Matlock42/AC_Clock/README.md

# AC Clock [WIP]  
I wanted to make a simplistic clock that would use 60Hz mains for both power and timing signal. This used to be quite common.
