Matlock42/AC_Clock/Docs/Readme.md

# Reference Designs

- [An Old-School Digital Clock - Nuts & Volts](https://www.nutsvolts.com/magazine/article/April2017_CMOS-ICs-Digital-Clock)

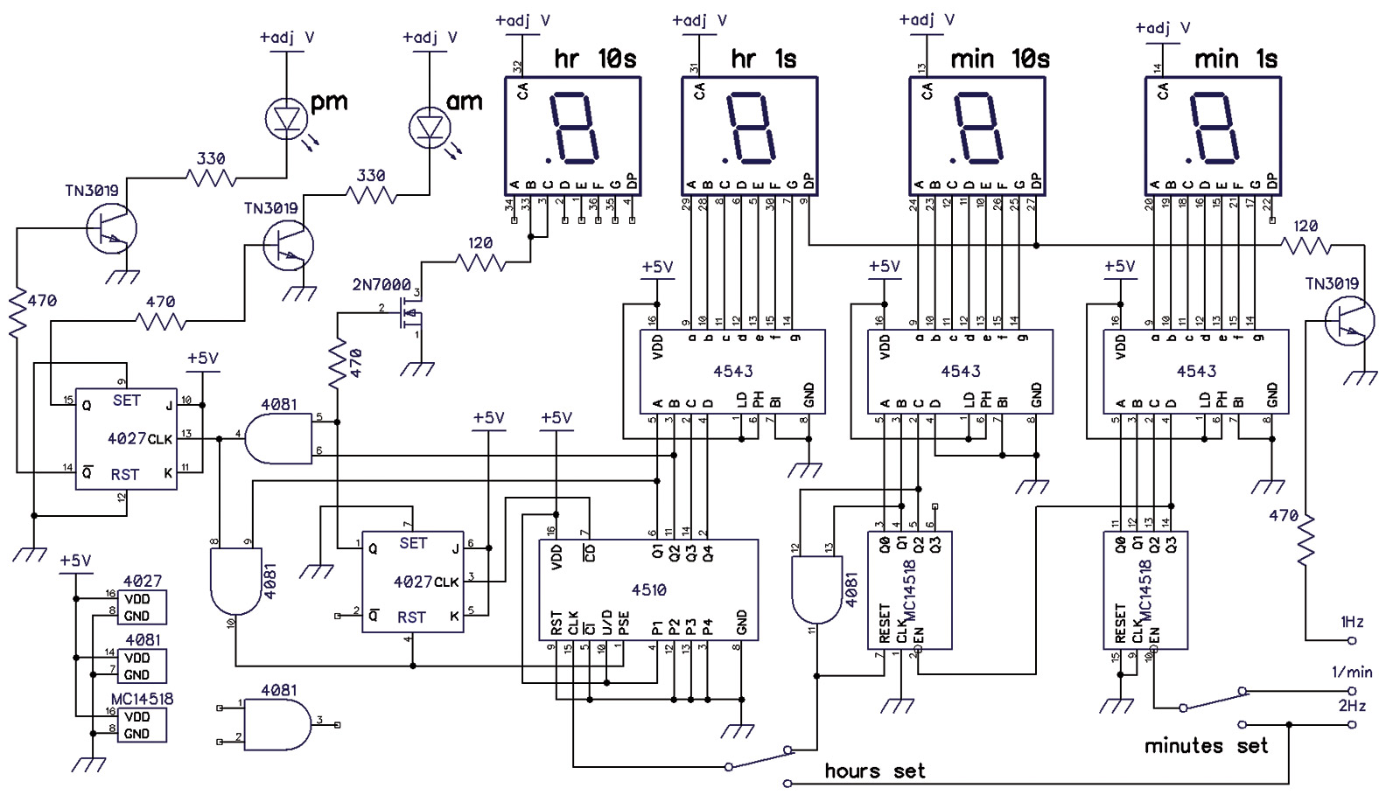
[picture p1: Docs/NV_0417_Julstrom_Figure03.jpg]
Counting Circuit


- [
Learning Sequential Logic Design for a Digital Clock by hp07](https://www.instructables.com/Digital-Clock-Sequential-Logic-Design/)
