Matlock42/AC_Clock/Calc/CurrentCalcs.xlsx

Device | MPN | Qty | I_max (mA) | Total
Counter | SN74HC393 | 4 | 15 | 60
BCD-to-7-Segment | CD74HC4511M96 | 4 | 0.1 | 0.4
Octocoupler | LTV-817S | 1 | 5 | 5
LED 7-segment | HDSP-815E | 4 | 70 | 280
12-stage Counter | CD4040B | 1
 |  |  |  | 345.4
