Matlock42/AC_Clock/Hardware/AC_Clock.kicad_pcb

## KiCad design Hardware/AC_Clock.kicad_pcb (2024-07-30)

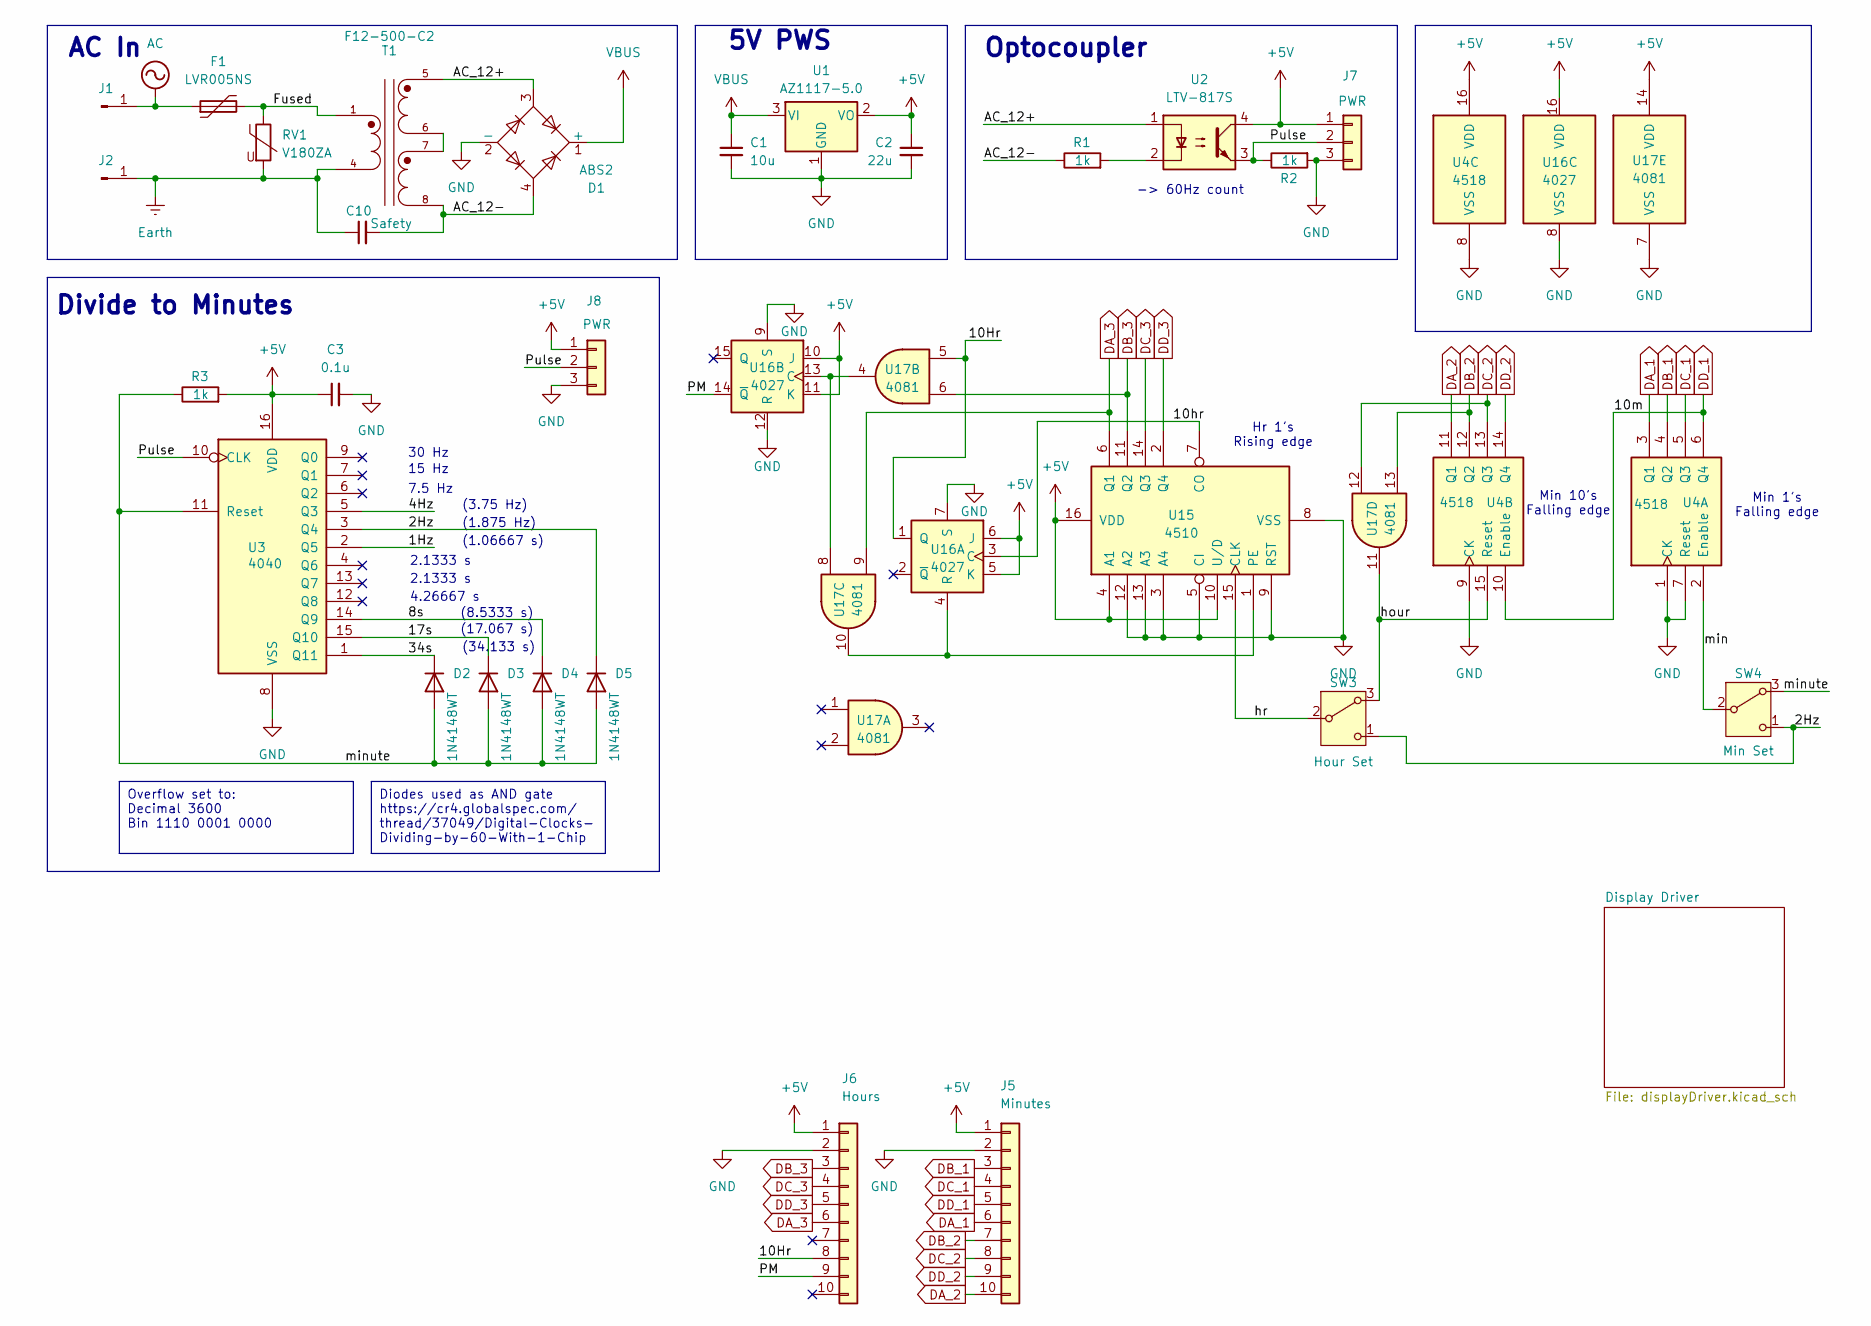
[picture p2: schematic AC_Clock.kicad_sch]

Parts:
C1: 10u; C_0603_1608Metric
C2: 22u; C_0603_1608Metric
C3: 0.1u; C_0603_1608Metric
C10: Safety; C_Disc_D10.5mm_W5.0mm_P7.50mm; MPN DE1E3RA102MJ4BN01F
D1: ABS2; Diode_Bridge_Diotec_ABS
D2, D3, D4, D5: 1N4148WT; D_SOD-523
F1: LVR005NS; Fuse_BelFuse_0ZRE0005FF_L8.3mm_W3.8mm
J1: L; Keystone_1287
J2: N; Keystone_1287
J5: Minutes; PinHeader_1x10_P2.54mm_Horizontal
J6: Hours; PinHeader_1x10_P2.54mm_Horizontal
J7: PWR; PinSocket_1x03_P2.54mm_Vertical
J8: PWR; PinHeader_1x03_P2.54mm_Vertical
R1, R2, R3: 1k; R_0603_1608Metric
RV1: V180ZA; RV_Disc_D7mm_W5.1mm_P5mm
SW3: Hour Set; SW_Push_CK_PN11SBNA03QE_SPDT_Right_Angle; MPN PN11SBNA03QE
SW4: Min Set; SW_Push_CK_PN11SBNA03QE_SPDT_Right_Angle; MPN PN11SBNA03QE
T1: F12-500-C2; XFMR_Triad_F12-500-C2
U1: AZ1117-5.0; SOT-223-3_TabPin2
U2: LTV-817S; SMDIP-4_W9.53mm
U3: 4040; DIP-16_W7.62mm
U4: 4518; DIP-16_W7.62mm
U15: 4510; DIP-16_W7.62mm
U16: 4027; DIP-16_W7.62mm
U17: 4081; DIP-14_W7.62mm

Connections:
+5V: C2.1, C3.1, J5.1, J6.1, J7.1, J8.1, R3.2, U1.2 (VO), U2.4, U3.16 (VDD), U4.16 (VDD), U15.4 (A1), U15.10 (U/D), U15.16 (VDD), U16.5 (K), U16.6 (J), U16.10 (J), U16.11 (K), U16.16 (VDD), U17.14 (VDD); also elsewhere on the board
/1Hz: U3.2 (Q5)
/2Hz: D5.1 (K), SW3.1 (C), SW4.1 (C), U3.3 (Q4)
/4Hz: U3.5 (Q3)
/8s: D4.1 (K), U3.14 (Q9)
/10Hr: J6.8, U16.1 (Q), U17.5
/10hr: U15.7 (CO), U16.3 (C)
/17s: D3.1 (K), U3.15 (Q10)
/34s: D2.1 (K), U3.1 (Q11)
/AC_12+: D1.3, T1.5, U2.1
/AC_12-: C10.2, D1.4, R1.1, T1.8
/Fused: F1.2, RV1.1, T1.1
/PM: J6.9, U16.14 (~Q)
/Pulse: J7.2, J8.2, R2.1, U2.3, U3.10 (CLK)
/hour: SW3.3 (A), U4.15 (Reset), U17.11
/hr: SW3.2 (B), U15.15 (CLK)
/min: SW4.2 (B), U4.2 (Enable)
/minute: D2.2 (A), D3.2 (A), D4.2 (A), D5.2 (A), R3.1, SW4.3 (A), U3.11 (Reset)
AC: F1.1, J1.1
DA_1: J5.6, U4.3 (Q1); also elsewhere on the board
DA_2: J5.10, U4.11 (Q1); also elsewhere on the board
DA_3: J6.6, U15.6 (Q1), U17.9; also elsewhere on the board
DB_1: J5.3, U4.4 (Q2); also elsewhere on the board
DB_2: J5.7, U4.12 (Q2), U17.13; also elsewhere on the board
DB_3: J6.3, U15.11 (Q2), U17.6; also elsewhere on the board
DC_1: J5.4, U4.5 (Q3); also elsewhere on the board
DC_2: J5.8, U4.13 (Q3), U17.12; also elsewhere on the board
DC_3: J6.4, U15.14 (Q3); also elsewhere on the board
DD_1: J5.5, U4.6 (Q4), U4.10 (Enable); also elsewhere on the board
DD_2: J5.9, U4.14 (Q4); also elsewhere on the board
DD_3: J6.5, U15.2 (Q4); also elsewhere on the board
Earth: C10.1, J2.1, RV1.2, T1.4
GND: C1.2, C2.2, C3.2, D1.2 (-), J5.2, J6.2, J7.3, J8.3, R2.2, U1.1 (GND), U3.8 (VSS), U4.1 (CK), U4.7 (Reset), U4.8 (VSS), U4.9 (CK), U15.3 (A4), U15.5 (CI), U15.8 (VSS), U15.9 (RST), U15.12 (A2), U15.13 (A3), U16.7 (S), U16.8 (VSS), U16.9 (S), U16.12 (R), U17.7 (VSS); also elsewhere on the board
unnamed: R1.2, U2.2
unnamed: T1.6, T1.7
unnamed: U15.1 (PE), U16.4 (R), U17.10
unnamed: U16.13 (C), U17.4, U17.8
VBUS: C1.1, D1.1 (+), U1.3 (VI)

Notes on the sheet:
Diodes used as AND gate https://cr4.globalspec.com/ thread/37049/Digital-Clocks- Dividing-by-60-With-1-Chip
Overflow set to: Decimal 3600 Bin 1110 0001 0000
-> 60Hz count
30 Hz
(34.133 s)
(17.067 s)
(1.875 Hz)
(3.75 Hz)
15 Hz
Optocoupler
5V PWS
(8.5333 s)
2.1333 s
7.5 Hz
4.26667 s
Divide to Minutes
(1.06667 s)
Min 10's Falling edge
AC In
Min 1's Falling edge
Hr 1's Rising edge

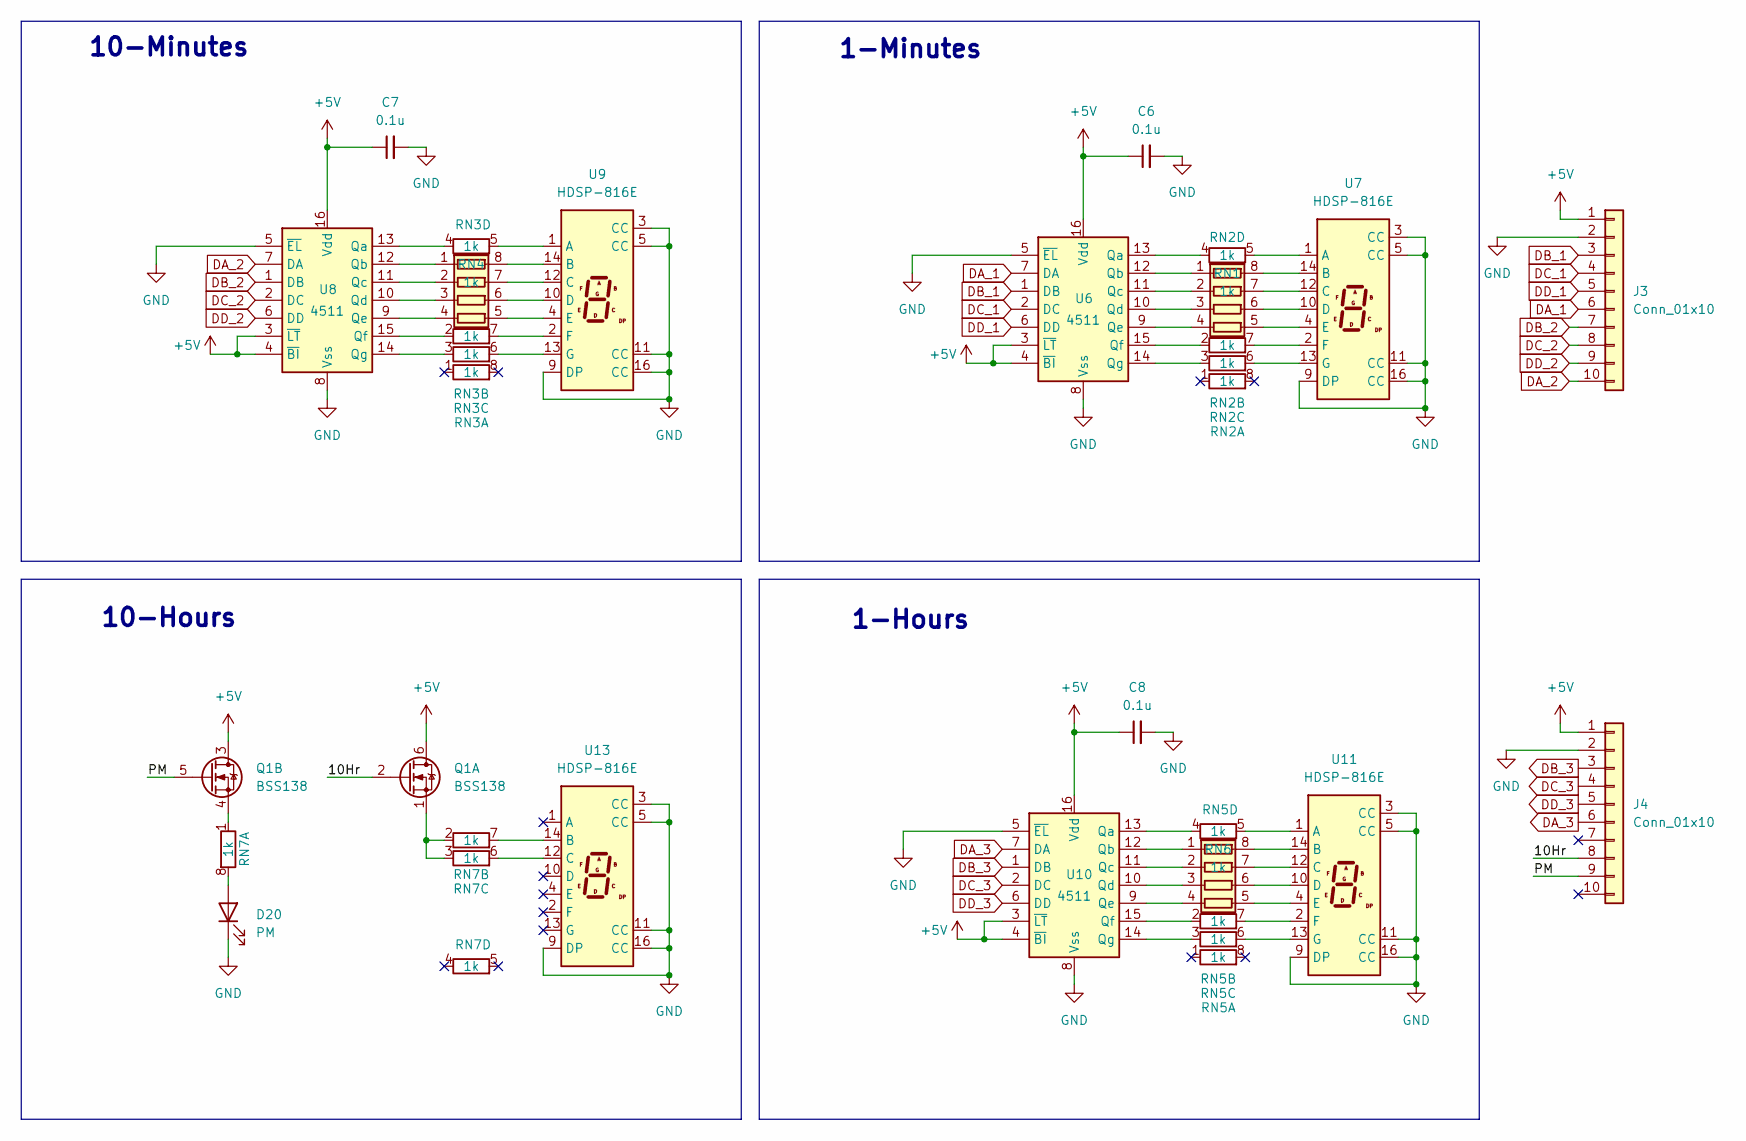
[picture p3: schematic displayDriver.kicad_sch]

Parts:
C6, C7, C8: 0.1u; C_0603_1608Metric
D20: PM; LED_D5.0mm
J3, J4: Conn_01x10; PinSocket_1x10_P2.54mm_Vertical
Q1: BSS138; SOT-363_SC-70-6
RN1, RN2, RN3, RN4, RN5, RN6, RN7: 1k; R_Array_Convex_4x0603
U6, U8, U10: 4511; TSSOP-16_4.4x5mm_P0.65mm
U7, U9, U11, U13: HDSP-816E; Broadcom_HDSP-81x

Connections:
+5V: C6.1, C7.1, C8.1, J3.1, J4.1, Q1.3 (D2), Q1.6 (D1), U6.3 (~LT), U6.4 (~BI), U6.16 (Vdd), U8.3 (~LT), U8.4 (~BI), U8.16 (Vdd), U10.3 (~LT), U10.4 (~BI), U10.16 (Vdd); also elsewhere on the board
/Display Driver/10Hr: J4.8, Q1.2 (G1)
/Display Driver/PM: J4.9, Q1.5 (G2)
DA_1: J3.6, U6.7 (DA); also elsewhere on the board
DA_2: J3.10, U8.7 (DA); also elsewhere on the board
DA_3: J4.6, U10.7 (DA); also elsewhere on the board
DB_1: J3.3, U6.1 (DB); also elsewhere on the board
DB_2: J3.7, U8.1 (DB); also elsewhere on the board
DB_3: J4.3, U10.1 (DB); also elsewhere on the board
DC_1: J3.4, U6.2 (DC); also elsewhere on the board
DC_2: J3.8, U8.2 (DC); also elsewhere on the board
DC_3: J4.4, U10.2 (DC); also elsewhere on the board
DD_1: J3.5, U6.6 (DD); also elsewhere on the board
DD_2: J3.9, U8.6 (DD); also elsewhere on the board
DD_3: J4.5, U10.6 (DD); also elsewhere on the board
GND: C6.2, C7.2, C8.2, D20.1 (K), J3.2, J4.2, U6.5 (~EL), U6.8 (Vss), U7.3 (CC), U7.5 (CC), U7.9 (DP), U7.11 (CC), U7.16 (CC), U8.5 (~EL), U8.8 (Vss), U9.3 (CC), U9.5 (CC), U9.9 (DP), U9.11 (CC), U9.16 (CC), U10.5 (~EL), U10.8 (Vss), U11.3 (CC), U11.5 (CC), U11.9 (DP), U11.11 (CC), U11.16 (CC), U13.3 (CC), U13.5 (CC), U13.9 (DP), U13.11 (CC), U13.16 (CC); also elsewhere on the board
unnamed: D20.2 (A), RN7.8 (R1.2)
unnamed: Q1.1 (S1), RN7.2 (R2.1), RN7.3 (R3.1)
unnamed: Q1.4 (S2), RN7.1 (R1.1)
unnamed: RN1.1 (R1.1), U6.12 (Qb)
unnamed: RN1.8 (R1.2), U7.14 (B)
unnamed: RN1.2 (R2.1), U6.11 (Qc)
unnamed: RN1.7 (R2.2), U7.12 (C)
unnamed: RN1.3 (R3.1), U6.10 (Qd)
unnamed: RN1.6 (R3.2), U7.10 (D)
unnamed: RN1.4 (R4.1), U6.9 (Qe)
unnamed: RN1.5 (R4.2), U7.4 (E)
unnamed: RN2.2 (R2.1), U6.15 (Qf)
unnamed: RN2.7 (R2.2), U7.2 (F)
unnamed: RN2.3 (R3.1), U6.14 (Qg)
unnamed: RN2.6 (R3.2), U7.13 (G)
unnamed: RN2.4 (R4.1), U6.13 (Qa)
unnamed: RN2.5 (R4.2), U7.1 (A)
unnamed: RN3.2 (R2.1), U8.15 (Qf)
unnamed: RN3.7 (R2.2), U9.2 (F)
unnamed: RN3.3 (R3.1), U8.14 (Qg)
unnamed: RN3.6 (R3.2), U9.13 (G)
unnamed: RN3.4 (R4.1), U8.13 (Qa)
unnamed: RN3.5 (R4.2), U9.1 (A)
unnamed: RN4.1 (R1.1), U8.12 (Qb)
unnamed: RN4.8 (R1.2), U9.14 (B)
unnamed: RN4.2 (R2.1), U8.11 (Qc)
unnamed: RN4.7 (R2.2), U9.12 (C)
unnamed: RN4.3 (R3.1), U8.10 (Qd)
unnamed: RN4.6 (R3.2), U9.10 (D)
unnamed: RN4.4 (R4.1), U8.9 (Qe)
unnamed: RN4.5 (R4.2), U9.4 (E)
unnamed: RN5.2 (R2.1), U10.15 (Qf)
unnamed: RN5.7 (R2.2), U11.2 (F)
unnamed: RN5.3 (R3.1), U10.14 (Qg)
unnamed: RN5.6 (R3.2), U11.13 (G)
unnamed: RN5.4 (R4.1), U10.13 (Qa)
unnamed: RN5.5 (R4.2), U11.1 (A)
unnamed: RN6.1 (R1.1), U10.12 (Qb)
unnamed: RN6.8 (R1.2), U11.14 (B)
unnamed: RN6.2 (R2.1), U10.11 (Qc)
unnamed: RN6.7 (R2.2), U11.12 (C)
unnamed: RN6.3 (R3.1), U10.10 (Qd)
unnamed: RN6.6 (R3.2), U11.10 (D)
unnamed: RN6.4 (R4.1), U10.9 (Qe)
unnamed: RN6.5 (R4.2), U11.4 (E)
unnamed: RN7.7 (R2.2), U13.14 (B)
unnamed: RN7.6 (R3.2), U13.12 (C)

Notes on the sheet:
10-Hours
1-Hours
10-Minutes
1-Minutes

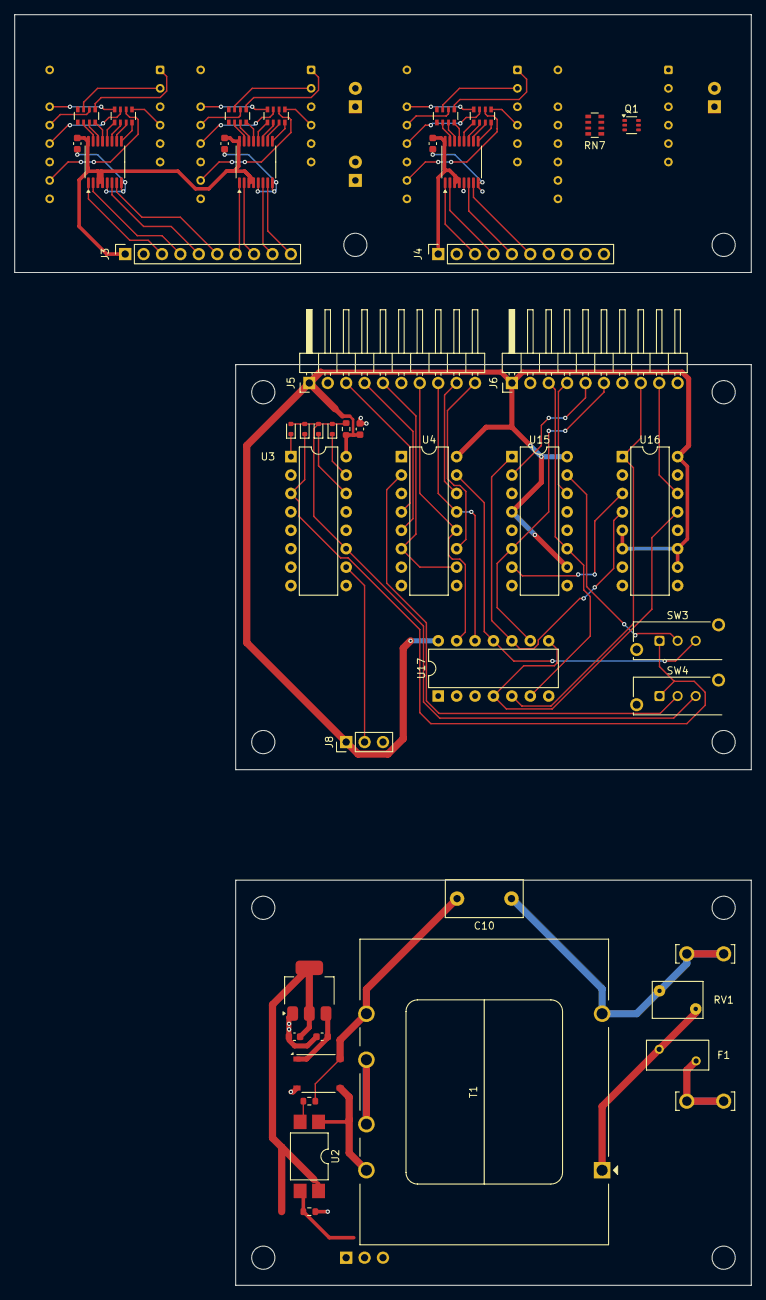
[picture p4: board AC_Clock.kicad_pcb from above]

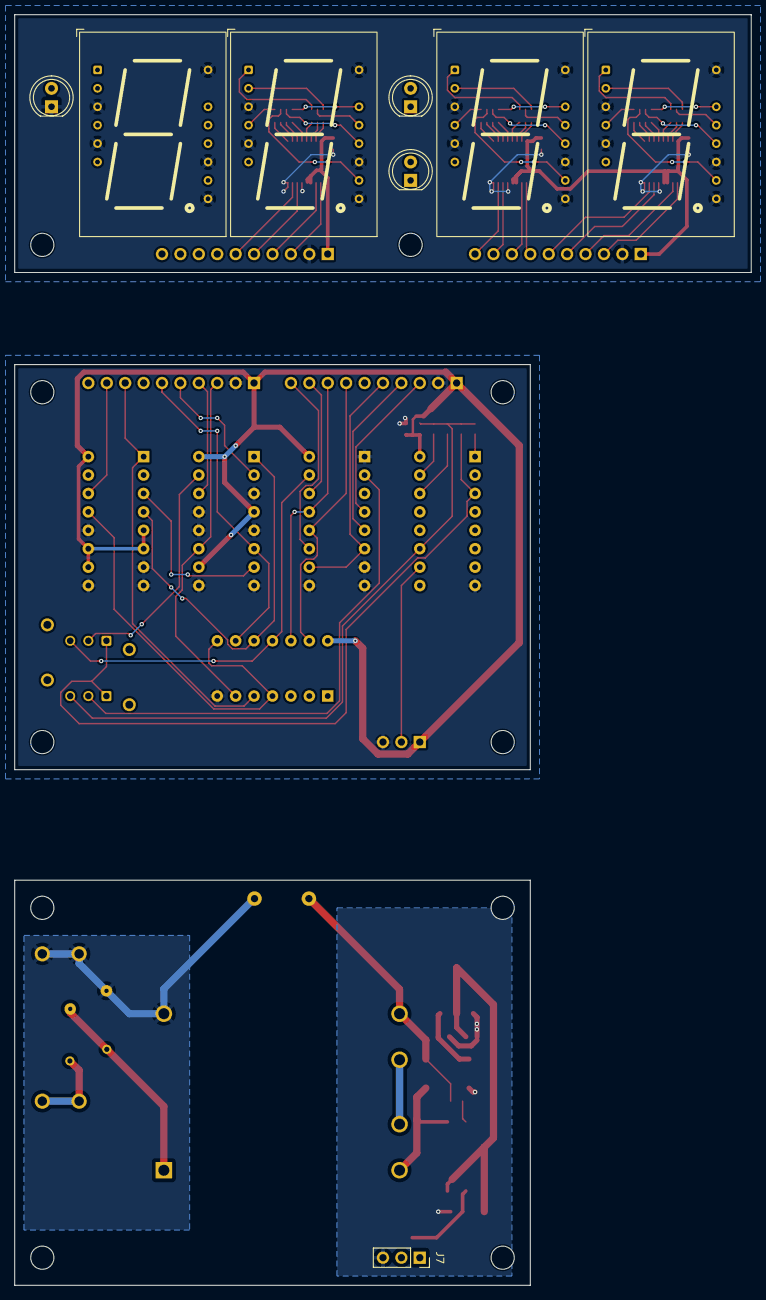
[picture p5: board AC_Clock.kicad_pcb from below]

Board: 2 copper layers, 101.6 x 175.3 mm, 51 parts (6 on the bottom side), 85 nets.
