Matlock42/AC_Clock/(commit log)

2024-06-26 Initalize Blank project
    [AC_Clock.kicad_pcb, AC_Clock.kicad_sch]
2024-06-26 Add Power circuits and pulse input
    [AC_Clock.kicad_pcb, AC_Clock.kicad_sch]
2024-06-26 Add current calculations
    [CurrentCalcs.xlsx]
2024-06-26 Add frequency divider (60Hz to min) and minutes counter
    [AC_Clock.kicad_sch]
2024-06-26 Add Hour Counter and display driver for minutes and ten minutes
    [AC_Clock.kicad_sch, displayDriver.kicad_sch]
2024-06-26 Add in BCD net-labels and clean up drawings.
    [AC_Clock.kicad_sch, displayDriver.kicad_sch]
2024-06-26 Add in hours and 10-hour display driver
    [displayDriver.kicad_sch]
2024-06-26 Add pushbuttons to be able to set time
    [AC_Clock.kicad_sch, displayDriver.kicad_sch]
2024-06-26 Set Footprints for components
    [AC_Clock.kicad_pcb, AC_Clock.kicad_sch, displayDriver.kicad_sch]
2024-06-26 Work on routing
    [AC_Clock.kicad_pcb, AC_Clock.kicad_sch]
2024-06-26 Add in correct calculated times for frequency divider
    [AC_Clock.kicad_pcb, AC_Clock.kicad_sch]
2024-06-26 Fix the counters' reset signals
    [AC_Clock.kicad_sch]
2024-06-28 Add in connectors for display board interconnect
    [AC_Clock.kicad_pcb, AC_Clock.kicad_sch, displayDriver.kicad_sch]
2024-06-28 Adjust minutes resistor packs to make them flow better
    [AC_Clock.kicad_pcb, displayDriver.kicad_sch]
2024-07-02 Wire up the 10/Minutes display
    [AC_Clock.kicad_pcb]
2024-07-02 Wire up the Hours connectors
    [AC_Clock.kicad_pcb, AC_Clock.kicad_sch, displayDriver.kicad_sch]
2024-07-02 Fix resistor arrays for more logical layout
    [AC_Clock.kicad_pcb, displayDriver.kicad_sch]
2024-07-02 Route the 10/hours digits. Update HDSP-816E footprint to include 3D representation
    [AC_Clock.kicad_pcb, displayDriver.kicad_sch]
2024-07-02 Finish routing main board
    [AC_Clock.kicad_pcb]
2024-07-03 Fix 12-bit counter overflow
    [AC_Clock.kicad_sch, displayDriver.kicad_sch]
2024-07-08 Add Class Y Safety capacitor
    [AC_Clock.kicad_pcb, AC_Clock.kicad_sch]
2024-07-08 Fix U2 footprint; change to DIP-4
    [AC_Clock.kicad_pcb, AC_Clock.kicad_sch]
2024-07-09 Fix routing and clean up silkscreen
    [AC_Clock.kicad_pcb]
2024-07-10 Add some notes on what ICs to change and switch Safety Capacitor to Y1 type
    [AC_Clock.kicad_sch]
2024-07-12 Make the IC changes for minute and hour counters
    [AC_Clock.kicad_sch, displayDriver.kicad_sch]
2024-07-12 Remove old ICs
    [AC_Clock.kicad_sch, displayDriver.kicad_sch]
2024-07-16 Change transformers and clean up some wiring
    [AC_Clock.kicad_sch]
2024-07-17 Clean up wiring and add comments
    [AC_Clock.kicad_sch]
2024-07-24 Update component symbols and footpints
    [AC_Clock.kicad_sch, displayDriver.kicad_sch]
2024-07-24 Convert layout to 3 board design (power/logic/display)
    [AC_Clock.kicad_pcb, AC_Clock.kicad_sch, displayDriver.kicad_sch]
2024-07-26 Route traces on new layout
    [AC_Clock.kicad_pcb, AC_Clock.kicad_sch]
2024-07-27 Change copper pour to clearance of 0.25mm
    [AC_Clock.kicad_pcb]
2024-07-30 Update board layout to minimize space used
    [AC_Clock.kicad_pcb, AC_Clock.kicad_sch]
2024-07-30 Move Power board layout to clear the Pushbuttons Add keepout.
    [AC_Clock.kicad_pcb]
2024-08-09 Change to fuse of correct value
    [AC_Clock.kicad_sch]
2026-09-04 Convert to KiCad9 and fix some issues
    - using class 2 xformer so no Class Y cap is needed.
    - Add reverse diode on optocoupler to prevent burnout
    - Diodes not working as AND so switched to CD4082 quad-AND
    - some minor improvements
    [AC_Clock.kicad_sch, displayDriver.kicad_sch]
2026-09-08 chore: update to actual displays
    Change generic displays to actual implemented displays. Includes new symbol library for the retro HP 5082 parts.
    Also update the power supply to use 7805 (due to thermals).
    [AC_Clock.kicad_sch, displayDriver.kicad_sch, pm_indicator.kicad_sch]
2026-09-15 chore: Finilize circuit parity
    Add colon LEDs
    Reannotate reference designations
    Update footprints
    [AC_Clock.kicad_sch, displayDriver.kicad_sch, pm_indicator.kicad_sch]
